iampratyusht/Autonomous-path-finding/CAD/README.md

## Chassis Design

- **Material:** 3D-printed PLA for lightweight and durability  
- **Design Software:** SolidWorks (chassis)
- **Structure:** Two-layer square chassis, `7.5` cm × `7.5` cm; total height `5.5` cm (with `34` mm wheels and `1.5` cm castor wheel)
- **Assembly:** Layers fastened with screws and corner poles; motors and battery sandwiched between layers for balance
- **Mounting:** Motor cases and brackets on lower layer; castor wheel at front; battery on lower layer for mass balance; PCB (`7` cm ×`7` cm) fixed on upper layer
- **Sensors:** IR sensors vertically mounted on 3D-printed supports at front, left, and right, oriented per datasheet

## **Images:**

- **Front**&#x20; 
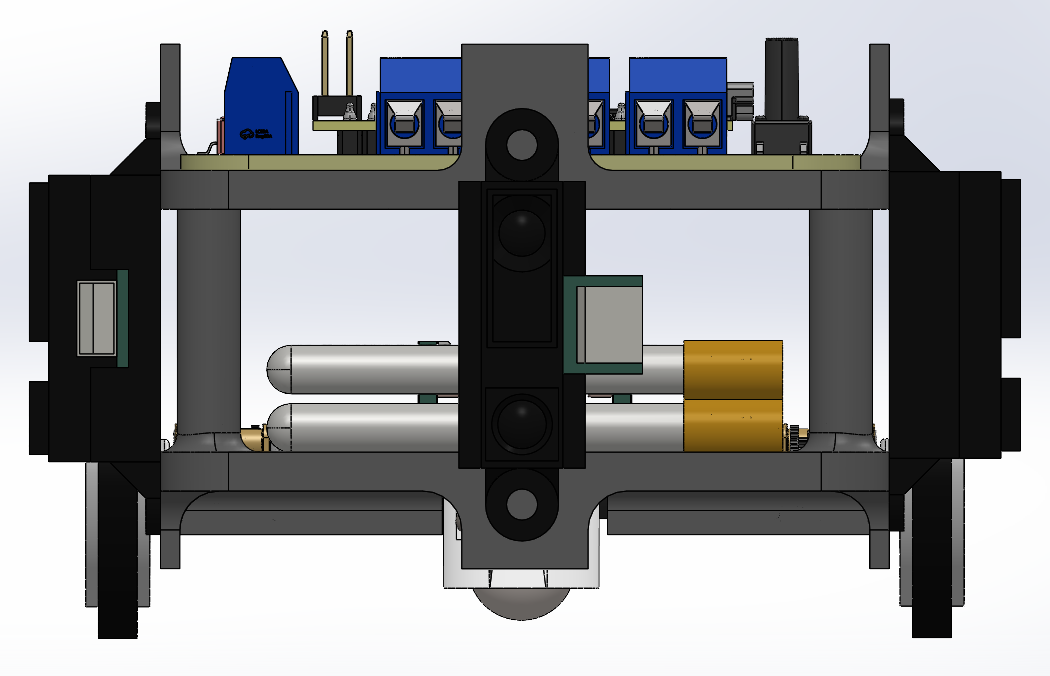
[picture p1: CAD/front.png]
Chassis front View
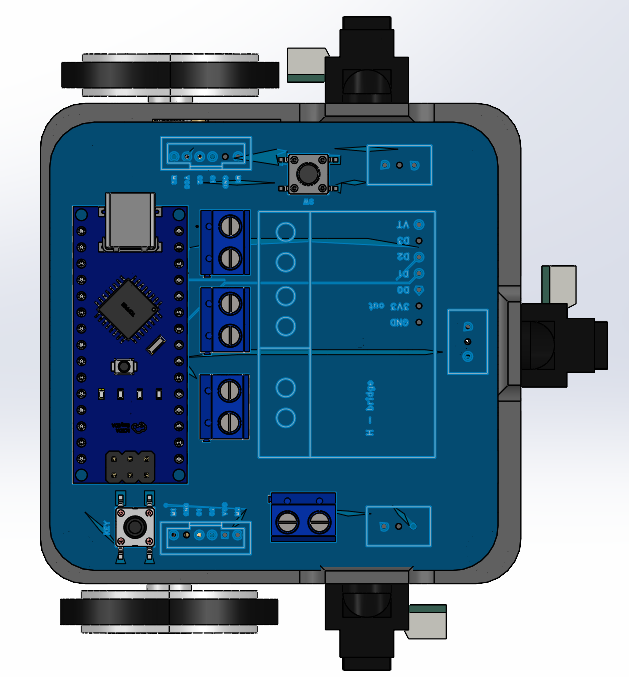
[picture p2: CAD/Top.png]
Chassis Top View
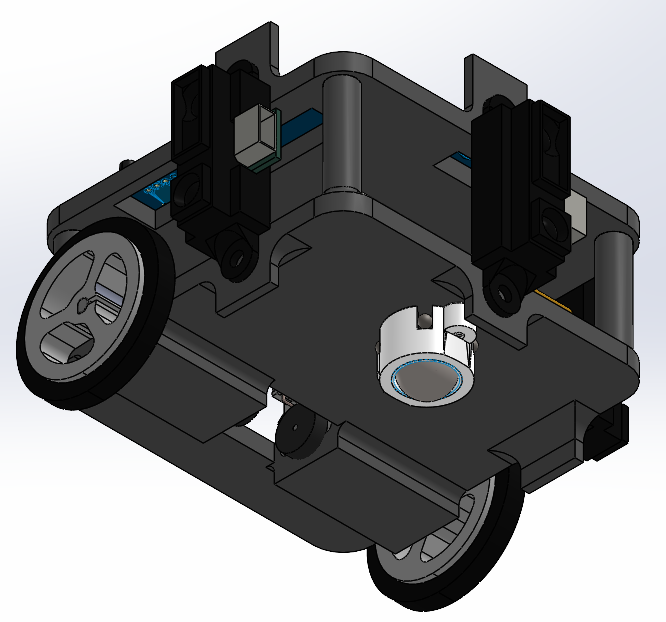
[picture p3: CAD/bottom.png]
Chassis bottom View
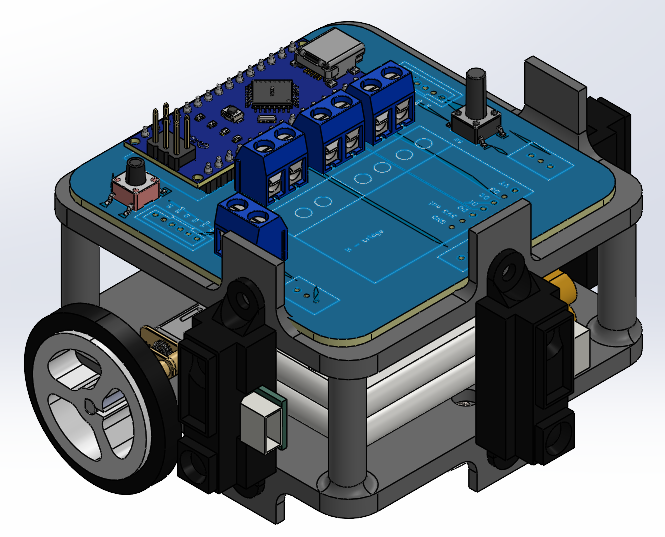
[picture p4: CAD/side.png]
Chassis side View
    

- **Top**&#x20;

- **Bottom**&#x20;

- **Side**&#x20;
